TrafalgarOp/Kaman/hardware/cba/kaman/Template.kicad_pcb

## KiCad design hardware/cba/kaman/Template.kicad_pcb (2026-07-20)

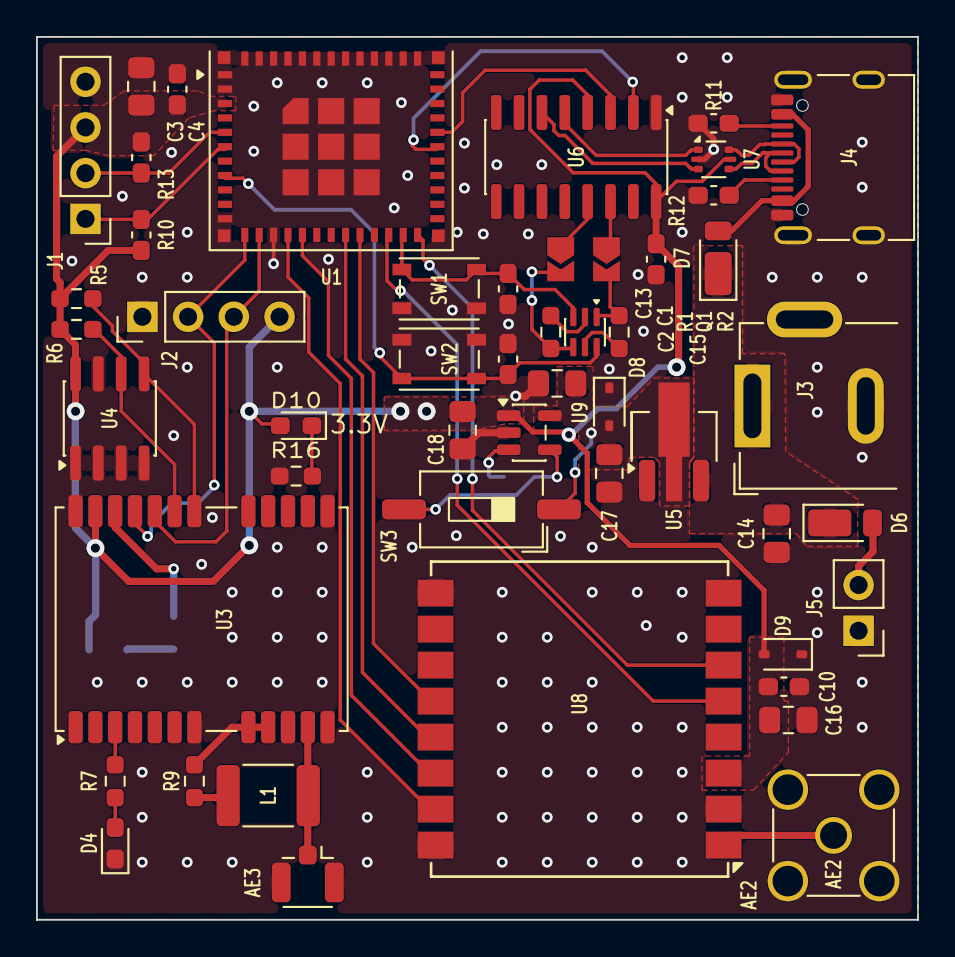
[picture p1: board Template.kicad_pcb from above]

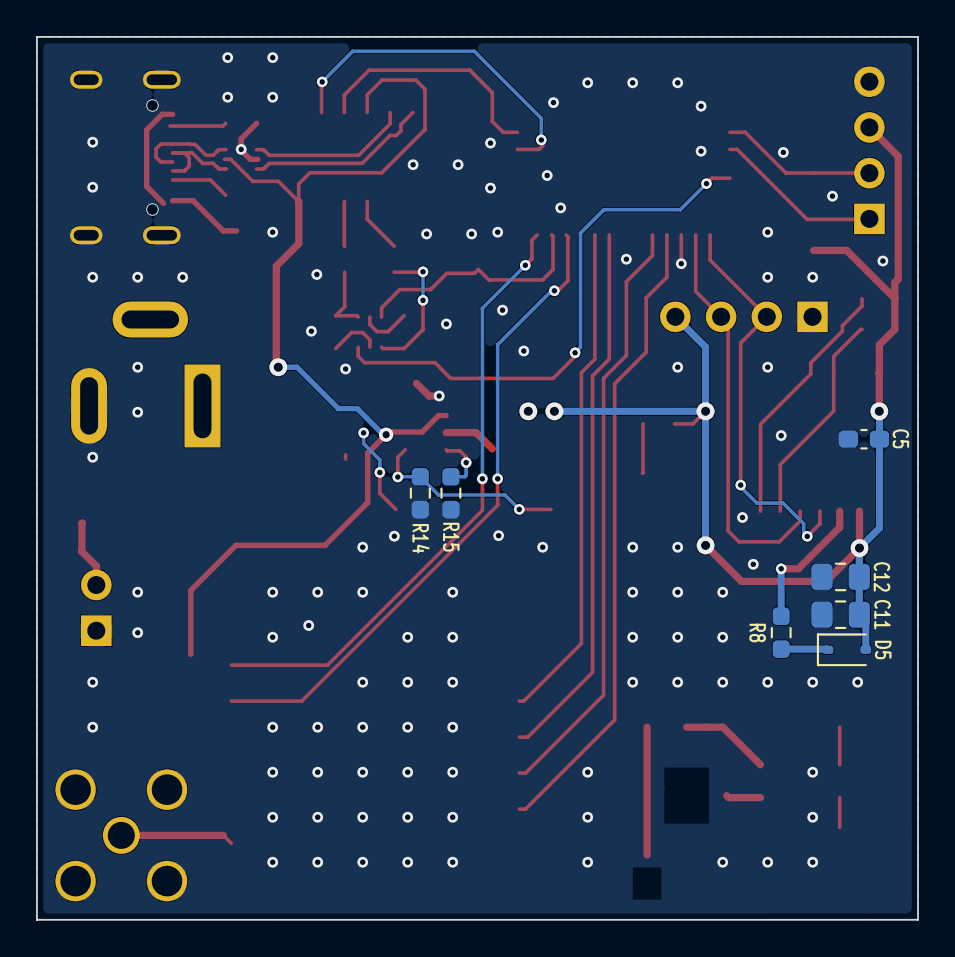
[picture p2: board Template.kicad_pcb from below]

Board: 2 copper layers, 48.9 x 49.0 mm, 57 parts (7 on the bottom side), 45 nets.

Parts:
AE2: Antenna_Shield; SMA_Amphenol_132134-11_Vertical
AE3: Antenna_Shield; U.FL_Hirose_U.FL-R-SMT-1_Vertical
C1, C2, C4, C5, C10, C13: 100nF; C_0603_1608Metric_Pad1.08x0.95mm_HandSolder
C3, C14, C15, C16, C17, C18: 10uF; C_0805_2012Metric_Pad1.18x1.45mm_HandSolder
C11, C12: 4.7uF; C_0805_2012Metric_Pad1.18x1.45mm_HandSolder
D4, D10: LED; LED_0603_1608Metric_Pad1.05x0.95mm_HandSolder
D5: 1N5819WT; D_SOD-323
D6, D7: DFLS160-7; D_PowerDI-123
D8: SD05C-01F; D_SOD-323
D9: SD03C-MMD; D_SOD-323
J1, J2: Conn_01x04_Pin; PinHeader_1x04_P2.54mm_Vertical
J3: Barrel_Jack_MountingPin; BarrelJack_GCT_DCJ200-10-A_Horizontal
J4: USB_C_Receptacle_USB2.0_16P; USB_C_Receptacle_G-Switch_GT-USB-7010ASV
J5: Conn_01x02_Socket; PinHeader_1x02_P2.54mm_Vertical
JP1, JP2: SolderJumper_2_Open; SolderJumper-2_P1.3mm_Open_TrianglePad1.0x1.5mm
L1: 27uH; L_1812_4532Metric_Pad1.30x3.40mm_HandSolder
Q1: MMDT5551; SOT-363_SC-70-6
R1, R2: 10K; R_0603_1608Metric_Pad0.98x0.95mm_HandSolder
R5, R6, R7, R8, R14, R16: 1K; R_0603_1608Metric_Pad0.98x0.95mm_HandSolder
R9: 22; R_0603_1608Metric_Pad0.98x0.95mm_HandSolder
R10, R13: 4.7K; C_0603_1608Metric_Pad1.08x0.95mm_HandSolder
R11, R12: 5.1K; C_0603_1608Metric_Pad1.08x0.95mm_HandSolder
R15: 6.8K; R_0603_1608Metric_Pad0.98x0.95mm_HandSolder
SW1, SW2: SW_Push; SW_SPST_PTS810
SW3: SW_DIP_x01; SW_DIP_SPSTx01_Slide_6.7x4.1mm_W8.61mm_P2.54mm_LowProfile
U1: ESP32-C6-MINI-1
U3: NEO-M8N; ublox_NEO
U4: AT24CS64-SSHM; SOIC-8_3.9x4.9mm_P1.27mm
U5: AZ1117-3.3; SOT-89-3_Handsoldering
U6: CH340C; SOIC-16_3.9x9.9mm_P1.27mm
U7: PRTR5V0U2D; SOT-666
U8: Ai-Thinker-Ra-01; Ai-Thinker-Ra-01-LoRa
U9: SY6280AAAC; SOT-23-5

Connections:
+3.3V: C3.1, C4.1, C5.1, C10.1, C11.1, C12.1, C13.1, C16.1, C18.1, D5.2 (A), D9.2 (A2), D10.2 (A), J1.3, J2.4, R5.1, R6.1, R10.1, R13.1, U1.3 (3V3), U3.23 (VCC), U4.8 (VCC), U6.4 (V3), U6.16 (VCC), U7.5 (VBUS), U8.3 (VDD), U9.1 (OUT)
/Project Architecture/IO Port/USB2_N: U6.6 (UD-), U7.3 (I/O2)
/Project Architecture/IO Port/USB2_P: U6.5 (UD+), U7.1 (I/O1)
/Project Architecture/IO Port/USB_N: J4.A7 (D-), J4.B7 (D-), U7.4 (I/O2)
/Project Architecture/IO Port/USB_P: J4.A6 (D+), J4.B6 (D+), U7.6 (I/O1)
/Project Architecture/MCU & GPS/VCC RF: R9.1, U3.8 (~RESET), U3.9 (VCC_RF)
BUSY LoRa: U1.22 (IO8), U8.5 (DIO0)
DIO1 LoRa: U1.24 (IO18), U8.6 (DIO1)
DTR: JP1.1 (A), U6.13 (~DTR)
EN: C2.2, Q1.6 (C1), SW2.2, U1.8 (EN)
GND: AE2.2 (Shield), AE3.2 (Shield), C1.1, C2.1, C3.2, C4.2, C5.2, C10.2, C11.2, C12.2, C13.2, C14.2, C15.2, C16.2, C17.2, C18.2, D4.1 (K), D8.1 (A1), D9.1 (A1), J1.4, J2.1, J3.2, J4.A1 (GND), J4.A12 (GND), J4.B1 (GND), J4.B12 (GND), J4.SH (SHIELD), J5.1, R11.1, R12.1, R14.2, R15.2, R16.1, SW1.1, SW2.1, U1.1 (GND), U1.2 (GND), U1.11 (GND), U1.14 (GND), U1.36 (GND), U1.37 (GND), U1.38 (GND), U1.39 (GND), U1.40 (GND), U1.41 (GND), U1.42 (GND), U1.43 (GND), U1.44 (GND), U1.45 (GND), U1.46 (GND), U1.47 (GND), U1.48 (GND), U1.49 (GND), U1.50 (GND), U1.51 (GND), U1.52 (GND), U1.53 (GND), U3.7 (VDD_USB), U3.10 (GND), U3.12 (GND), U3.13 (GND), U3.24 (GND), U4.1 (A0), U4.2 (A1), U4.3 (A2), U4.4 (GND), U4.7 (WP), U5.1 (GND), U6.1 (GND), U7.2 (GND), U8.2 (GND), U8.9 (GND), U8.16 (GND), U9.2 (GND)
GPIO 9: C1.2, Q1.3 (C2), SW1.2, U1.23 (IO9)
GPS RX: J2.2, U1.12 (IO0), U3.21 (RXD/SPI_MOSI)
GPS TX: J2.3, U1.13 (IO1), U3.20 (TXD/SPI_MISO)
MISO LoRa: U1.16 (IO7), U8.14 (MOSI)
MOSI LoRa: U1.19 (IO14), U8.13 (MISO)
NSS LoRa: U1.15 (IO6), U8.15 (~NSS)
unnamed: AE2.1 (A), U8.1 (ANT)
unnamed: AE3.1 (A), L1.2, U3.11 (RF_IN)
unnamed: D4.2 (A), R7.2
unnamed: D5.1 (K), R8.1
unnamed: D6.2 (A), J5.2
unnamed: D7.2 (A), J4.A4 (VBUS), J4.A9 (VBUS), J4.B4 (VBUS), J4.B9 (VBUS)
unnamed: C15.1, C17.1, D8.2 (A2), SW3.1, U5.2 (VO), U9.5 (IN)
unnamed: D10.1 (K), R16.2
unnamed: J4.A5 (CC1), R12.2
unnamed: J4.B5 (CC2), R11.2
unnamed: JP1.2 (B), Q1.4 (E2), R1.1
unnamed: JP2.2 (B), Q1.1 (E1), R2.1
unnamed: L1.1, R9.2
unnamed: Q1.2 (B1), R1.2
unnamed: Q1.5 (B2), R2.2
unnamed: R6.2, U3.19 (SCL/SPI_CLK), U4.6 (SCL)
unnamed: R5.2, U3.18 (SDA/~SPI_CS), U4.5 (SDA)
unnamed: R7.1, U3.3 (TIMEPULSE)
unnamed: R8.2, U3.22 (V_BCKP)
unnamed: R14.1, SW3.2, U9.4 (EN)
unnamed: R15.1, U9.3 (ISET)
RTS: JP2.1 (A), U6.14 (~RTS)
SCK LoRa: U1.20 (IO15), U8.12 (SCK)
SCL Oled: J1.2, R13.2, U1.5 (IO2)
SDA Oled: J1.1, R10.2, U1.6 (IO3)
UART RX: U1.30 (RXD0), U6.2 (TXD)
UART TX: U1.31 (TXD0), U6.3 (RXD)
VDD: C14.1, D6.1 (K), D7.1 (K), J3.1, U5.3 (VI)
