TrafalgarOp/Kaman/(commit log)

2026-07-08 hw(pcb): made the files for the pcb
    [Template.kicad_pcb, Template.kicad_sch, block_diagram.kicad_sch, project_architecture.kicad_sch]
2026-07-09 docs(datasheets): add the reference design for ESP32 C6 and Quectel L80
    This files are a reference not the datasheet for this parts and datasheets will be added later on
2026-07-09 hw(schematic): Draw the schematic part of ESP32 C6
    Add the ESP32 C6 and it's necessary part's needed for it to function such as the decoupling caps, the auto program circuit and buttons needed
    [Template.kicad_sch, interface.kicad_sch, io_port.kicad_sch, mcu_gps.kicad_sch, power.kicad_sch, project_architecture.kicad_sch]
2026-07-10 hw(schmatic): add L80 GPS Module
    L80 and the circuit such as the decoupling caps,reset and PPS pin, and
    most importantly the backup battery (although the footprint has to be
    checked)
    [mcu_gps.kicad_sch]
2026-07-10 chore(git): add placeholder files to track remaining empty directories
2026-07-10 hw(schematic): add NEO-MXN GPS module
    Add U blox NEO GPS module which has the same footprint even with change
    of generations and the EEPROM IC,antenna and the battery holder
    [mcu_gps.kicad_sch]
2026-07-10 hw(schematic): USB to UART circuit for ESP32
    With CH340C the UBS to UART for programming the ESP32 is done and it has
    the ESD protection with the type C port and the VBUS on USB isn't used
    [io_port.kicad_sch]
2026-07-11 hw(schematic): add oled and gps module connector
    [io_port.kicad_sch, mcu_gps.kicad_sch]
2026-07-12 hw(schematic): add the power section
    Three power sources USB, DC Jack and simple 2.54mm connector with a
    schottkey diode on USB and simple ones to block reverse current into a
    AZ1117 and outputs 3.3v
    [io_port.kicad_sch, power.kicad_sch, project_architecture.kicad_sch]
2026-07-15 hw(schematic): Change reverse current diodes
    The previous schottky 1N5819WT is rated for 350mA which needs two for
    maximum of 700mA and is repalced with DFLS160-7 which is rated for 1A
    [io_port.kicad_sch, power.kicad_sch]
2026-07-15 hw(schematic): change main mcu version
    Change ESP32 C6 WROOM to the mini version due to size constraints on pcb
    [mcu_gps.kicad_sch]
2026-07-15 hw(schematic): add pullup resistors to oled I2C
    [io_port.kicad_sch]
2026-07-15 hw(pcb): pcb design starter point
    [Template.kicad_pcb]
2026-07-15 hw(pcb): unrouted v0.1 pcb
    [Template.kicad_pcb]
2026-07-16 hw(pcb): add missing 3d models for parts
    [Template.kicad_pcb, io_port.kicad_sch, mcu_gps.kicad_sch]
2026-07-17 hw(pcb): unorganized overlay 0.1v pcb
    [Template.kicad_pcb, io_port.kicad_sch, mcu_gps.kicad_sch]
2026-07-17 hw(schmatic): add ra-01 LoRa module
    The second rf solution is done by ra-01 and the circuit needed to work
    was pulled from datasheet and for antenna connector an SMA type is used
    and there is a UFL on the module too
    [mcu_gps.kicad_sch]
2026-07-17 hw(schematic): add a power switch for 3.3v
    To turn off the board with the input power still connected a dip switch
    with a power switch has been added and it will take care of currnet
    limiting to 1A and reverse currents
    [io_port.kicad_sch, power.kicad_sch]
2026-07-20 hw(schematic): fix the wrong usb connection
    [io_port.kicad_sch]
2026-07-20 hw(schematic): add an led indicator for 3.3v
    [power.kicad_sch]
2026-07-20 hw(pcb): final 0.2v pcb
    [Template.kicad_pcb, Template.kicad_sch, mcu_gps.kicad_sch]
2026-07-20 hw(pcb): add a DRC file for nextpcb
